Phobos132/PhobGCC/PCB/Motherboard/Motherboard JLCpcb/PhobGCC.csv

Comment | Designator | Footprint | LCSC
0.047u | C1,C2,C3,C4,C5,C6,C7 | Capacitors_SMD:C_0603_HandSoldering | C1622
1u | C8,C9,C10,C11,C12 | Capacitors_SMD:C_0603_HandSoldering | C15849
D_Schottky | D1 | Gamecube MB:D_SOD-523_large_pads | C8524
2k | R1,R2 | Resistor_SMD:R_0603_1608Metric | C22975
ME6206A25XG | U3 | Package_TO_SOT_SMD:SOT-23_Handsoldering | C236704
