Phobos132/PhobGCC/PCB/Models/D2LS_21.step

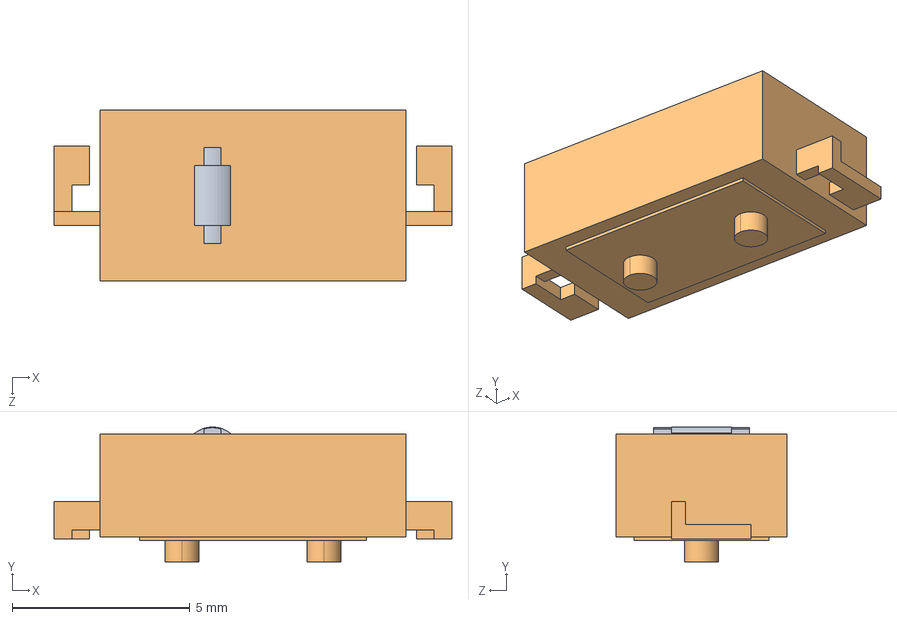
[picture p1: CAD file, 2022-03-23]
PCB/Models/D2LS_21.step
11.2 x 3.80 x 4.80 mm
D2LS_21_BUTTON
D2LS_21_BASE
