Phobos132/PhobGCC/(threads)

Thread 1 (2022-01-13):

Document Snapback Filtering

Phobos132, 2022-01-13:
Need to describe how the kalman filtering uses the acceleration and ADV variation values to remove snapback while keeping response fast when the stick is near the gate

Closed 2022-01-19.

Thread 3 (2022-01-13):

Create Full Build Instructions

Phobos132, 2022-01-13:
Need to fully document the build process including:
Ordering Boards
Ordering Parts
Disassembling a controller
Assembling the board
Programming the Teensy

Thread 41 (2022-04-14):

20xx controller configuration UI

Phobos132, 2022-04-14:
Rework the controller configuration UI so that calibration can be done easily in 20xx as well as smashscope

Phobos132, 2022-04-14:
Rienne's suggested control scheme:

Safe Mode
    AXY+start (Hold)
Hard Reset
    ABZ+start (Hold)
Enter Analog Stick Calibration
    AXY+R
Enter C-stick Calibration
    AXY+L
  Advance Calibration Step
    A
  Undo Calibration Step
    B
  Notch Adjustment CW/CCW
    X / Y

Increase/Decrease Snapback Filtering on X
    ZX+DpadUp/Down
Increase/Decrease Snapback Filtering on Y
    ZY+DpadUp/Down
Show Current Snapback Setting
    ZA+DpadDown

Switch X with Z
    Xstart+Z
Switch Y with Z
    Ystart+Z
Reset Z-jump
    AXY+Z (Hold)

Toggle Analog L slider
    Zstart+L
Toggle Analog R slider
    Zstart+R

Increase/Decrease Analog Rise Delay X-axis
    RX+DpadUp/Down
Increase/Decrease Analog Rise Delay Y-axis
    RY+DpadUp/Down
Show Current Analog Stick Offset
    RA+DpadDown

Increase /Decrease  C-stick Offset X-axis
    LX+DpadUp/Down
Increase/Decrease C-stick Offset Y-axis
    LY+DpadUp/Down
Show Current C-stick Offset
    LA+DpadDown

Closed 2022-05-01.

Thread 42 (2022-04-14):

Calibration Noise Measurement

Phobos132, 2022-04-14:
Add a way to measure sensor noise during calibration and set a hysteresis value based on it
