Phobos132/PhobGCC/PCB/CStick/CStick.kicad_pcb

## KiCad design PCB/CStick/CStick.kicad_pcb (2022-03-27)

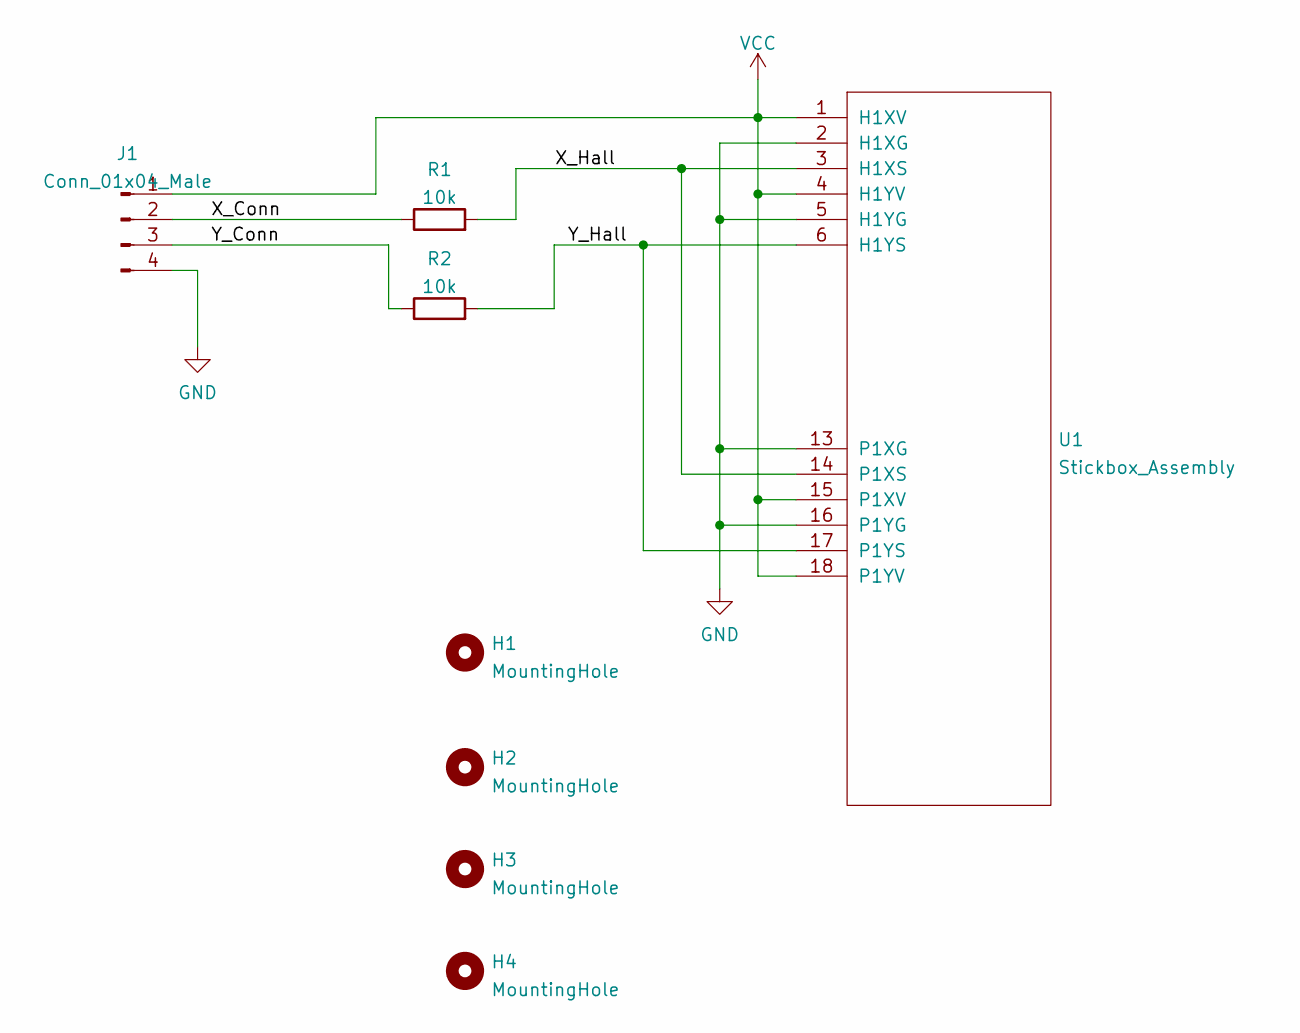
[picture p3: schematic CStick.kicad_sch]

Parts:
H1: MountingHole; MountingHole_1.8mm
H2: MountingHole; MountingHole_5.2mm
H3, H4: MountingHole; MountingHole_2.0mm
J1: Conn_01x04_Male; PinHeader_1x04_P2.00mm_Vertical
R1, R2: 10k; R_0603_1608Metric_Pad0.98x0.95mm_HandSolder
U1: Stickbox_Assembly; GCC_Stickbox_2

Connections:
/X_Conn: J1.2, R1.1
/X_Hall: R1.2, U1.3 (H1XS), U1.14 (P1XS)
/Y_Conn: J1.3, R2.1
/Y_Hall: R2.2, U1.6 (H1YS), U1.17 (P1YS)
GND: J1.4, U1.2 (H1XG), U1.5 (H1YG), U1.13 (P1XG), U1.16 (P1YG)
VCC: J1.1, U1.1 (H1XV), U1.4 (H1YV), U1.15 (P1XV), U1.18 (P1YV)

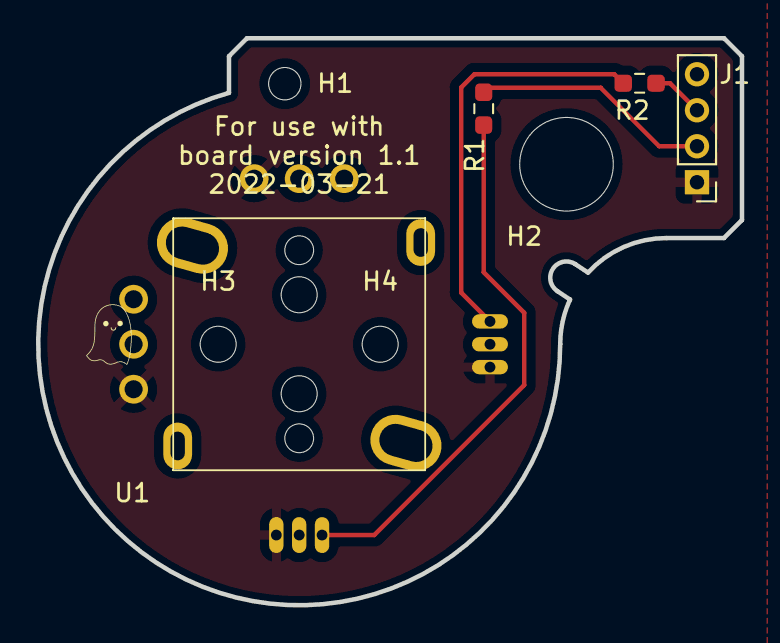
[picture p4: board CStick.kicad_pcb from above]

Board: 2 copper layers, 39.1 x 31.5 mm, 8 parts (0 on the bottom side), 6 nets.
