Phobos132/PhobGCC/PCB/Motherboard/PhobGCC.kicad_pcb

## KiCad design PCB/Motherboard/PhobGCC.kicad_pcb (2022-03-25)

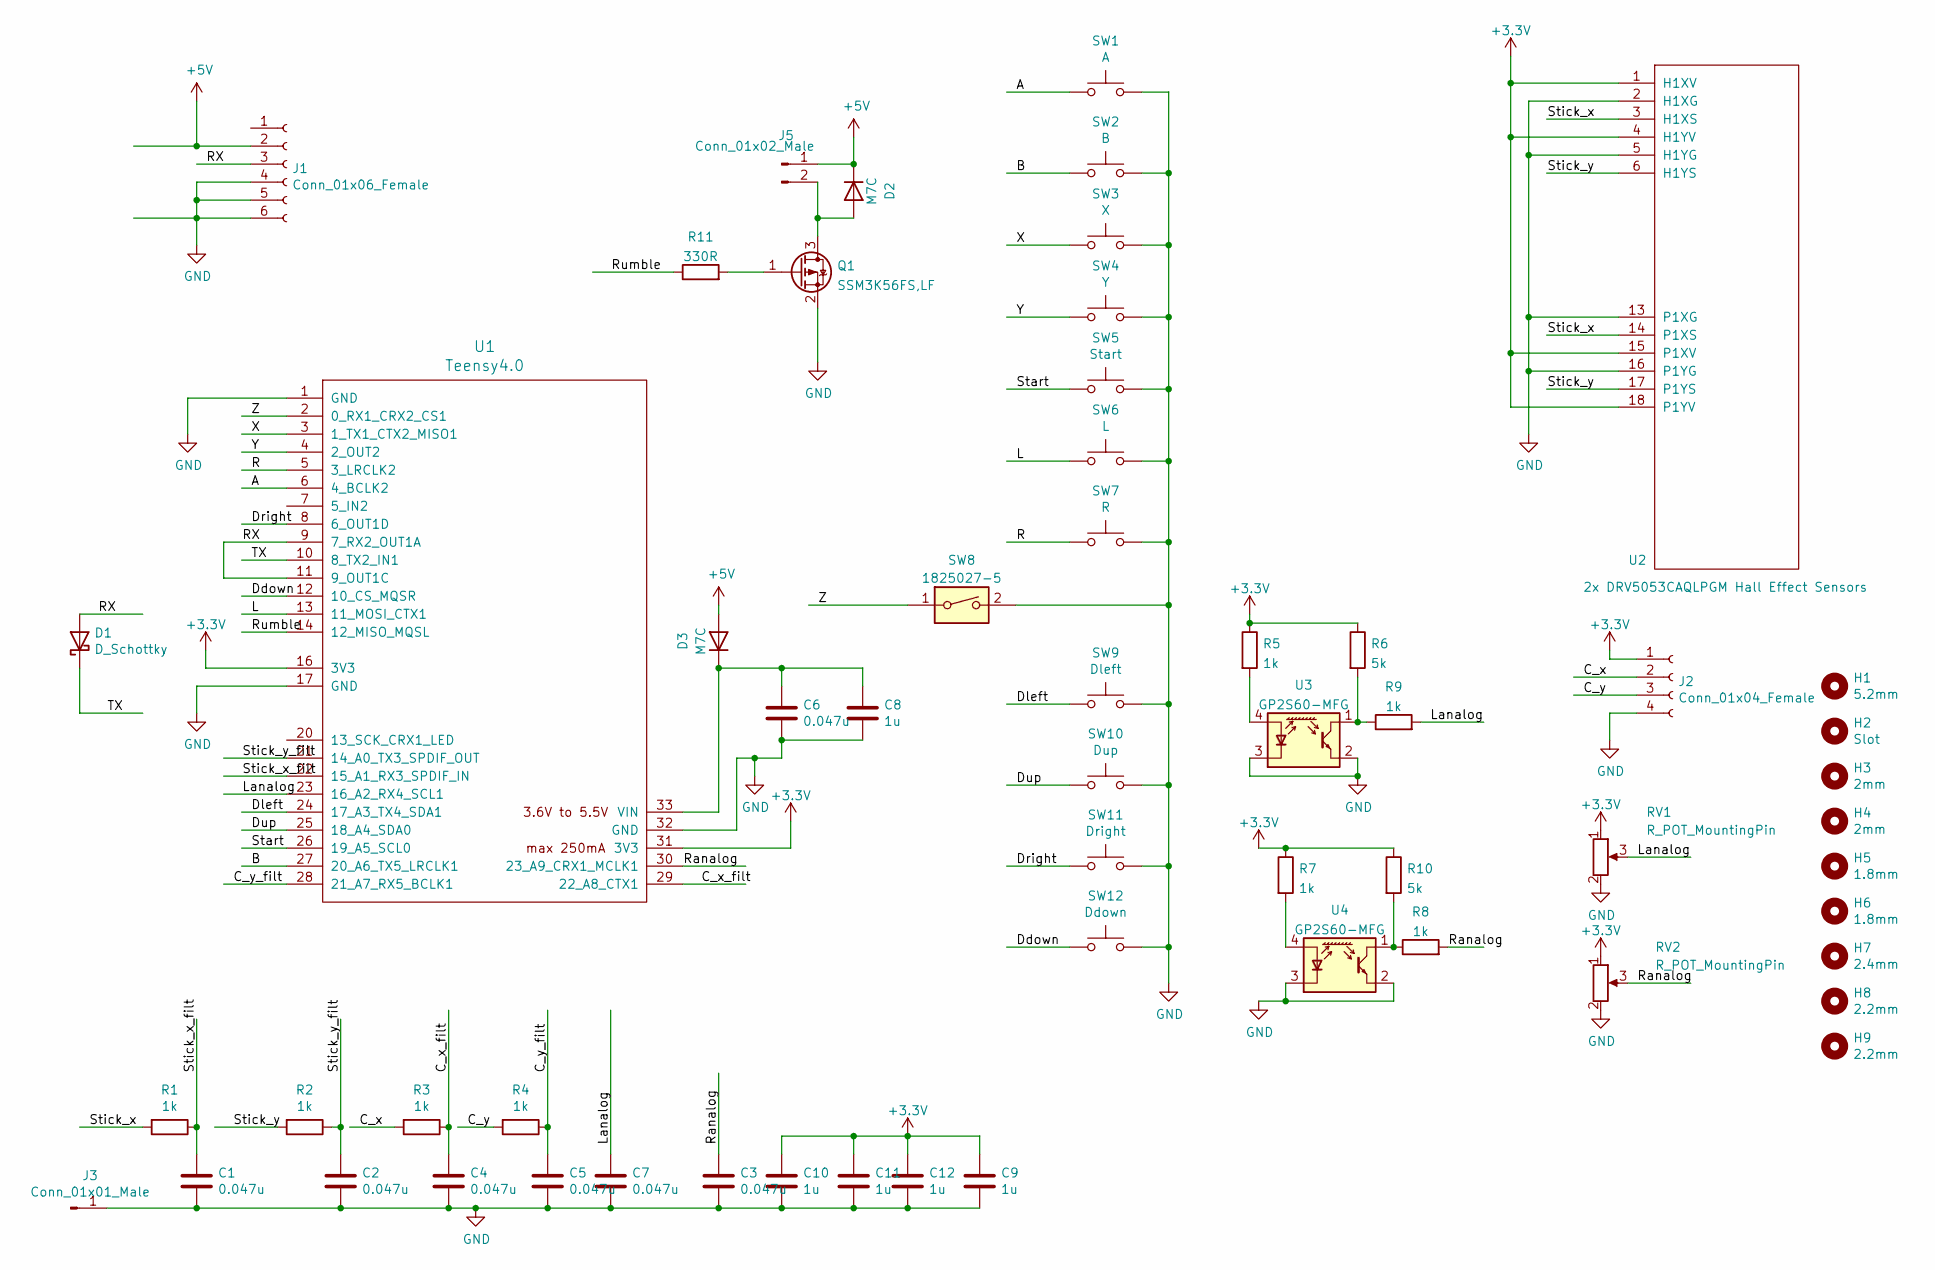
[picture p5: schematic PhobGCC.kicad_sch]

Parts:
C1, C2, C3, C4, C5, C6, C7: 0.047u; C_0603_HandSoldering; MPN 0603B222K500NT; LCSC C1604
C8, C9, C10, C11, C12: 1u; C_0603_1608Metric_Pad1.08x0.95mm_HandSolder; MPN CL10A105KB8NNNC; LCSC C15849
D1: D_Schottky; D_SOD-523_large_pads; Manufacturer PN RB751S-40; LCSC C8524
D2, D3: M7C; D_SOD-123F; MPN M7; LCSC C95872
H1: 5.2mm; MountingHole_5.2mm
H2: Slot
H3, H4: 2mm; MountingHole_2.0mm
H5, H6: 1.8mm; MountingHole_1.8mm
H7: 2.4mm; MountingHole_2.4mm
H8, H9: 2.2mm; MountingHole_2.2mm
J1: Conn_01x06_Female; GCC_Header_Straight_1x06_Pitch2.00mm
J2: Conn_01x04_Female; Pin_Header_Straight_1x04_Pitch2.00mm
J3: Conn_01x01_Male; PinHeader_1x01_P2.54mm_Vertical
J5: Conn_01x02_Male; PinHeader_1x02_P2.54mm_Vertical
Q1: SSM3K56FS,LF; SOT-23; MPN 2N7002; LCSC C8545
R1: 1k; R_0603_1608Metric_Pad0.98x0.95mm_HandSolder; Manufacturer PN 0603WAF1002T5ECopy; LCSC C25804
R2, R3, R4, R5, R7, R8, R9: 1k; R_0603_1608Metric_Pad0.98x0.95mm_HandSolder; MPN 0603WAF1002T5E; LCSC C25804
R6, R10: 5k; R_0603_1608Metric_Pad0.98x0.95mm_HandSolder; MPN 0603WAF4701T5E; LCSC C23162
R11: 330R; R_0603_1608Metric_Pad0.98x0.95mm_HandSolder; MPN 0603WAF3300T5E; LCSC C23138
RV1, RV2: R_POT_MountingPin; GCC_Slider
SW1: A; ABXY_Contact_Omron_Switch
SW2: B; ABXY_Contact_Omron_Switch
SW3: X; ABXY_Contact_Omron_Switch
SW4: Y; ABXY_Contact_Omron_Switch
SW5: Start; Start_Contact
SW6: L; Pin_Header_Straight_1x02_Pitch2.54mm
SW7: R; Pin_Header_Straight_1x02_Pitch2.54mm
SW8: 1825027-5; Z_Switch_Edge
SW9: Dleft; Dpad_Contact
SW10: Dup; Dpad_Contact
SW11: Dright; Dpad_Contact
SW12: Ddown; Dpad_Contact
U1: Teensy4.0; Teensy40_Edge_Pins
U2: 2x DRV5053CAQLPGM Hall Effect Sensors; GCC_Stickbox_2
U3, U4: GP2S60-MFG; Sharp_Microelectronics-GP2S60-MFG

Connections:
+3V3: C9.1, C10.1, C11.1, C12.1, J2.1, R5.1, R6.1, R7.1, R10.1, RV1.1 (V+), RV2.1 (V+), U1.16 (3V3), U1.31 (3V3), U2.1 (H1XV), U2.4 (H1YV), U2.15 (P1XV), U2.18 (P1YV)
+5V: D2.1 (K), D3.2 (A), J1.2, J5.1
/A: SW1.1, U1.6 (4_BCLK2)
/B: SW2.1, U1.27 (20_A6_TX5_LRCLK1)
/C_x: J2.2, R3.2
/C_x_filt: C4.1, R3.1, U1.29 (22_A8_CTX1)
/C_y: J2.3, R4.2
/C_y_filt: C5.1, R4.1, U1.28 (21_A7_RX5_BCLK1)
/Ddown: SW12.1, U1.12 (10_CS_MQSR)
/Dleft: SW9.1, U1.24 (17_A3_TX4_SDA1)
/Dright: SW11.1, U1.8 (6_OUT1D)
/Dup: SW10.1, U1.25 (18_A4_SDA0)
/L: SW6.1, U1.13 (11_MOSI_CTX1)
/Lanalog: C7.1, R9.2, RV1.3 (Signal), U1.23 (16_A2_RX4_SCL1)
/R: SW7.1, U1.5 (3_LRCLK2)
/RX: D1.2 (A), J1.3, U1.9 (7_RX2_OUT1A), U1.11 (9_OUT1C)
/Ranalog: C3.1, R8.2, RV2.3 (Signal), U1.30 (23_A9_CRX1_MCLK1)
/Rumble: R11.1, U1.14 (12_MISO_MQSL)
/Start: SW5.1, U1.26 (19_A5_SCL0)
/Stick_x: R1.2, U2.3 (H1XS), U2.14 (P1XS)
/Stick_x_filt: C1.1, R1.1, U1.22 (15_A1_RX3_SPDIF_IN)
/Stick_y: R2.2, U2.6 (H1YS), U2.17 (P1YS)
/Stick_y_filt: C2.1, R2.1, U1.21 (14_A0_TX3_SPDIF_OUT)
/TX: D1.1 (K), U1.10 (8_TX2_IN1)
/X: SW3.1, U1.3 (1_TX1_CTX2_MISO1)
/Y: SW4.1, U1.4 (2_OUT2)
/Z: SW8.1, U1.2 (0_RX1_CRX2_CS1)
GND: C1.2, C2.2, C3.2, C4.2, C5.2, C6.2, C7.2, C8.2, C9.2, C10.2, C11.2, C12.2, J1.4, J1.5, J1.6, J2.4, J3.1, Q1.2 (S), RV1.2 (GND), RV2.2 (GND), SW1.2, SW2.2, SW3.2, SW4.2, SW5.2, SW6.2, SW7.2, SW8.2, SW9.2, SW10.2, SW11.2, SW12.2, U1.1 (GND), U1.17 (GND), U1.32 (GND), U2.2 (H1XG), U2.5 (H1YG), U2.13 (P1XG), U2.16 (P1YG), U3.2 (E), U3.3 (K), U4.2 (E), U4.3 (K)
unnamed: C6.1, C8.1, D3.1 (K), U1.33 (VIN)
unnamed: D2.2 (A), J5.2, Q1.3 (D)
unnamed: Q1.1 (G), R11.2
unnamed: R5.2, U3.4 (A)
unnamed: R6.2, R9.1, U3.1 (C)
unnamed: R7.2, U4.4 (A)
unnamed: R8.1, R10.2, U4.1 (C)

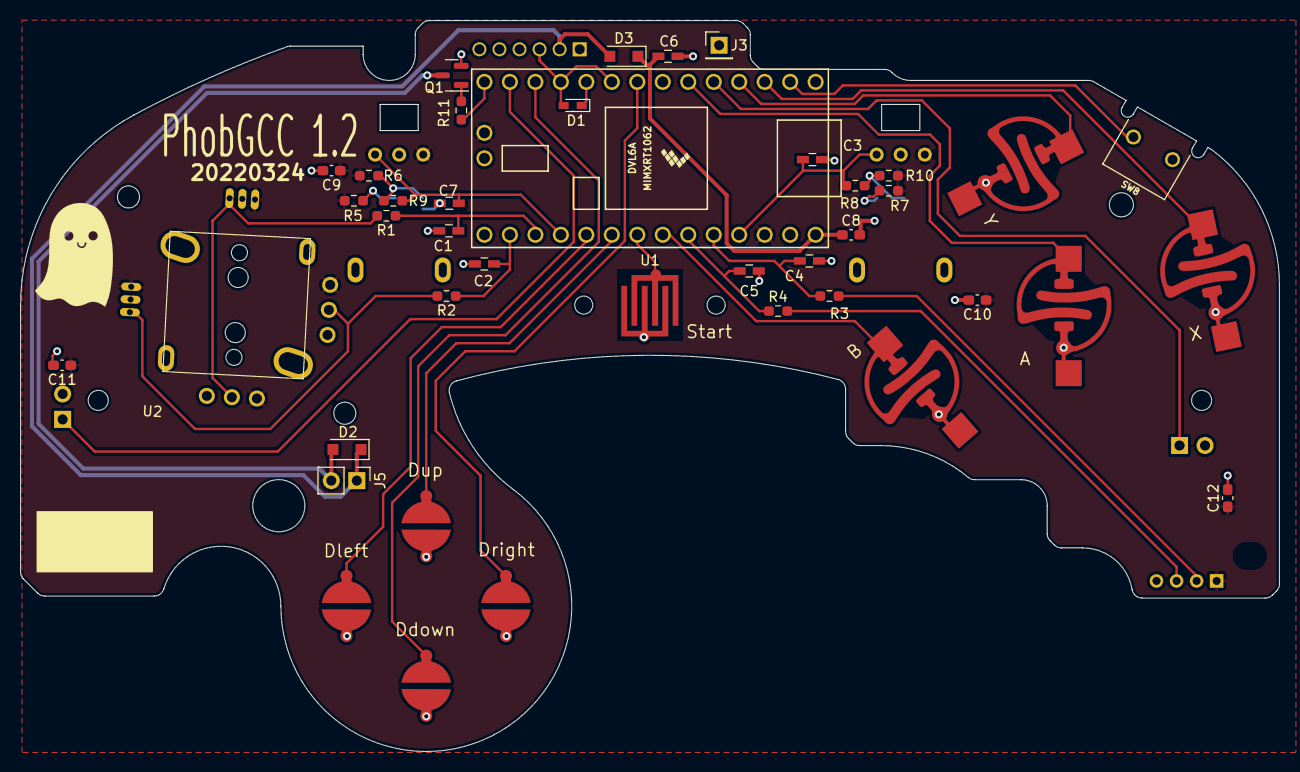
[picture p6: board PhobGCC.kicad_pcb from above]

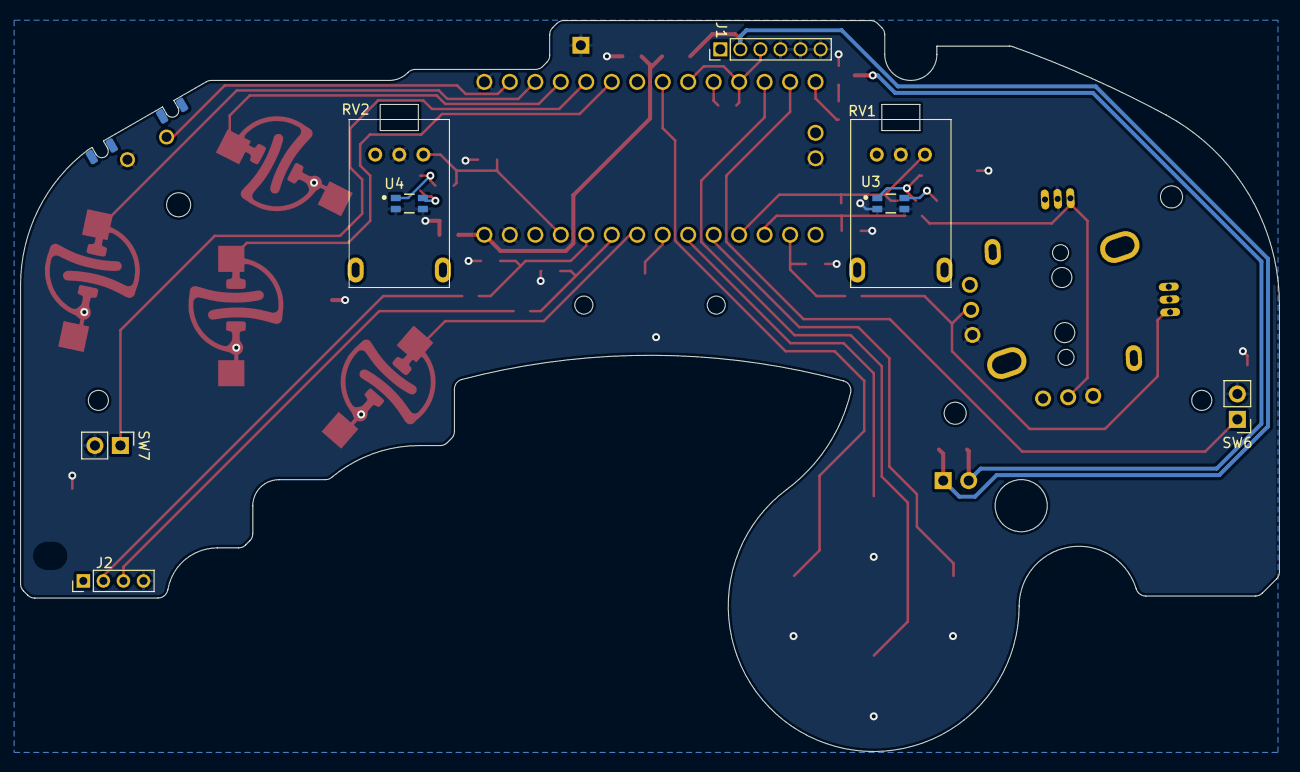
[picture p7: board PhobGCC.kicad_pcb from below]

Board: 2 copper layers, 125.5 x 72.9 mm, 58 parts (8 on the bottom side), 35 nets.
