Phobos132/PhobGCC/(commit log)

2022-03-16 First code commit for using the Teensy 4.0 on the 1.1 board version. Had to rewrite the communication code and a bit of setup to make it work.
2022-03-26 cherry pick improved filter from main
2022-03-26 Remove integral correction from kalman filter
    It did essentially nothing at all in the end.
    [PhobGCC.ino]
2022-03-27 Added the missing mounting holes to the c-stick
    [CStick.kicad_pcb, CStick.kicad_sch]
2022-03-27 fixed Notch Adjustment
    Loop was running so fast that loopDelta was getting truncated to 0. changing it to float fixes it.
    [PhobGCC.ino]
2022-03-28 update comment for stick filter
2022-03-28 Adjust Snapback Fix
    Snapback can now be adjusted on the new filter.
    [PhobGCC.ino]
2022-03-29 Updated JLCPCB part numbers for the resistor and capacitors, was still 10k and 2.2nF instead of 2k and 47nF
    [PhobGCC.csv]
